mike-rankin/Pong-Clock/PCB/Oled_PCB/3.3v_OLED_PCB_Rev1.PDF

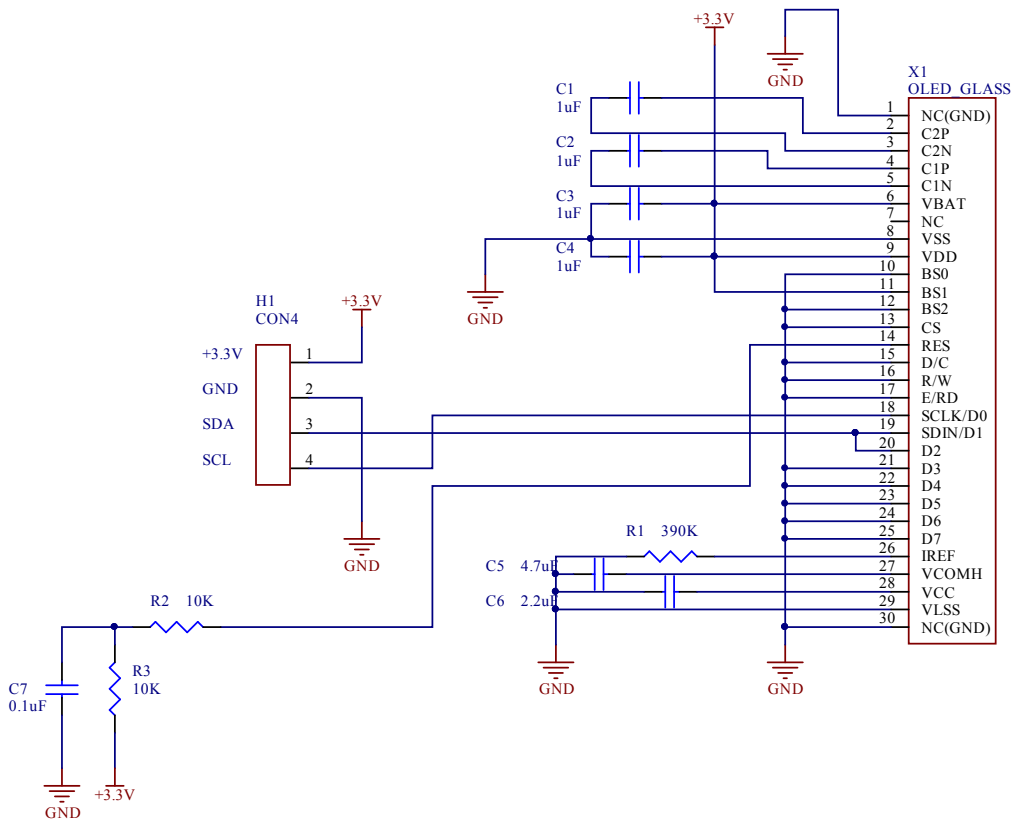
[picture p5: page 1]

2 2 | 0 1
