mike-rankin/Pong-Clock/(list of files, drawings)

Other design files:
PCB/Main_PCB/Pong_Clock.PrjPCB
PCB/Main_PCB/Pong_Clock_R2.5.PcbDoc
PCB/Main_PCB/Schematic_R2.5.SchDoc
PCB/Oled_PCB/OLED_PCB_Rev1.1.PcbDoc
PCB/Oled_PCB/OLED_PCB_Rev1.1.PrjPCB
PCB/Oled_PCB/OLED_PCB_Rev1.SchDoc
