mike-rankin/Pong-Clock/Code/Menu.h

#ifndef MENU_H
#define MENU_H

#include <Arduino.h>
#include <Adafruit_GFX.h>

enum Menu_selection {
  MENU_CLOCK,
  MENU_SETTINGS,
  MENU_SETTINGS_24H,
  MENU_SETTINGS_TIME,
  MENU_SETTINGS_DATE,
  MENU_SETTINGS_BRIGHTNESS,
  MENU_SETTINGS_CLOCKFACE,

  MENU_MAX
};

class Menu {
public:
  Menu(Menu_selection t) : type(t) {}
  bool update();
  void draw(Adafruit_GFX* display) const;
  void button1();
  void button2();

  Menu_selection getType() const { return type; }
protected:
  Menu_selection type;
  void drawLayout(Adafruit_GFX* display, const __FlashStringHelper* title) const;
};

// Change the current menu
void switchMenu(Menu_selection);
// To be called from the .ino to actually do the menu switch.
void updateMenuSelection();

#endif
