mike-rankin/Pong-Clock/Code/Menu_Settings_24.h

#ifndef MENU_SETTINGS_24_H
#define MENU_SETTINGS_24_H

#include <Arduino.h>
#include "Menu.h"

class Settings24hMenu : public Menu {
public:
  Settings24hMenu();
  bool update();
  void button1();
  void button2();
  void draw(Adafruit_GFX* display) const;
};

#endif
